Red-Lucy-Engineering/eater-deluxe/eater-deluxe.step

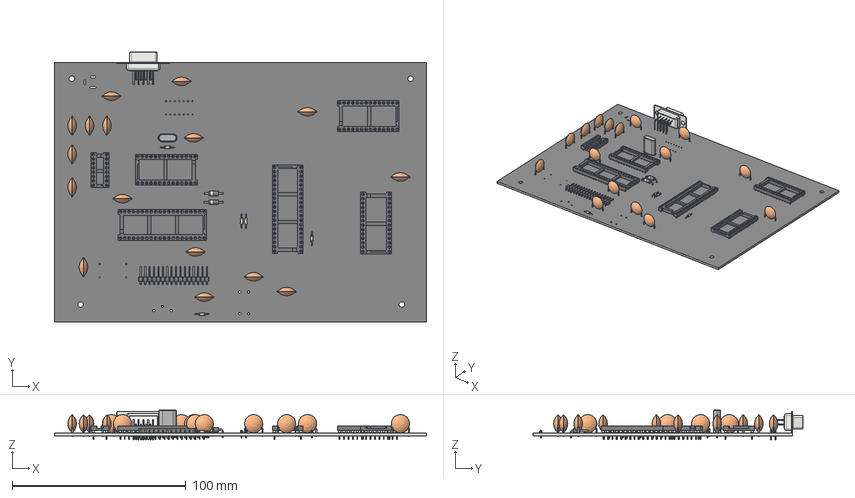
[picture p1: CAD file, 2026-08-22]
eater-deluxe.step
214.2 x 155.4 x 17.0 mm
C_Disc_D105mm_W50mm_P1000mm x 16
DIP_28_W1524mm_Socket x 3
DIP_40_W1524mm_Socket x 2
D_DO-41_SOD81_P10.16mm_Horizontal x 2
PinHeader_1x16_P254mm_Horizontal
R_Axial_DIN0204_L36mm_D16mm_P762mm_Horizontal x 5
DIP_16_W762mm_Socket
Crystal_HC49-U_Vertical
DSUB-9_Socket_Horizontal_P2.77x2.54mm_EdgePinOffset9.40mm
eater-deluxe-unsaved-export-r1S9HQ_soldermask x 2
eater-deluxe-unsaved-export-r1S9HQ_PCB
