Red-Lucy-Engineering/eater-deluxe/schematics/eater-deluxe.pdf

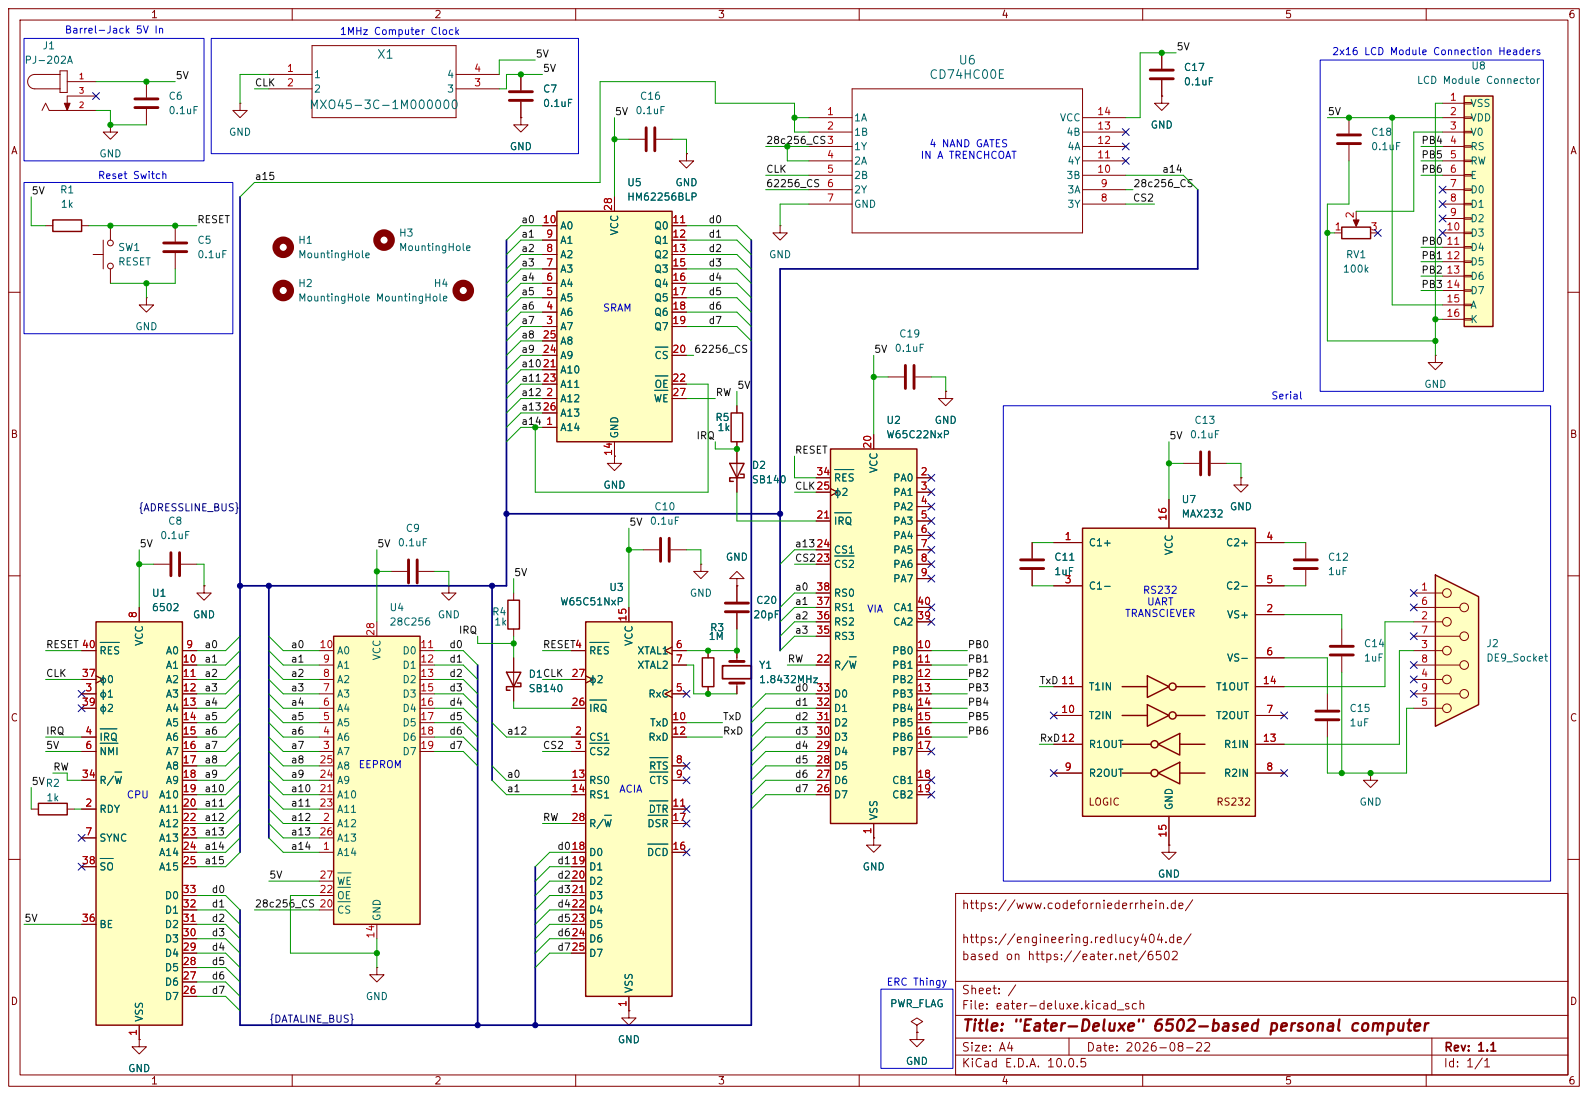
[picture p2: page 1]

https://www.codeforniederrhein.de/ VSS

https://engineering.redlucy404.de/
based on https://eater.net/6502

Sheet: /
File: eater-deluxe.kicad_sch
Title: "Eater-Deluxe" 6502-based personal computer

Size: A4 | Rev: 1.1
KiCad E.D.A. 10.0.5 | Id: 1/1
