Red-Lucy-Engineering/eater-deluxe/eater-deluxe.kicad_pcb

## KiCad design eater-deluxe.kicad_pcb (2026-08-23)

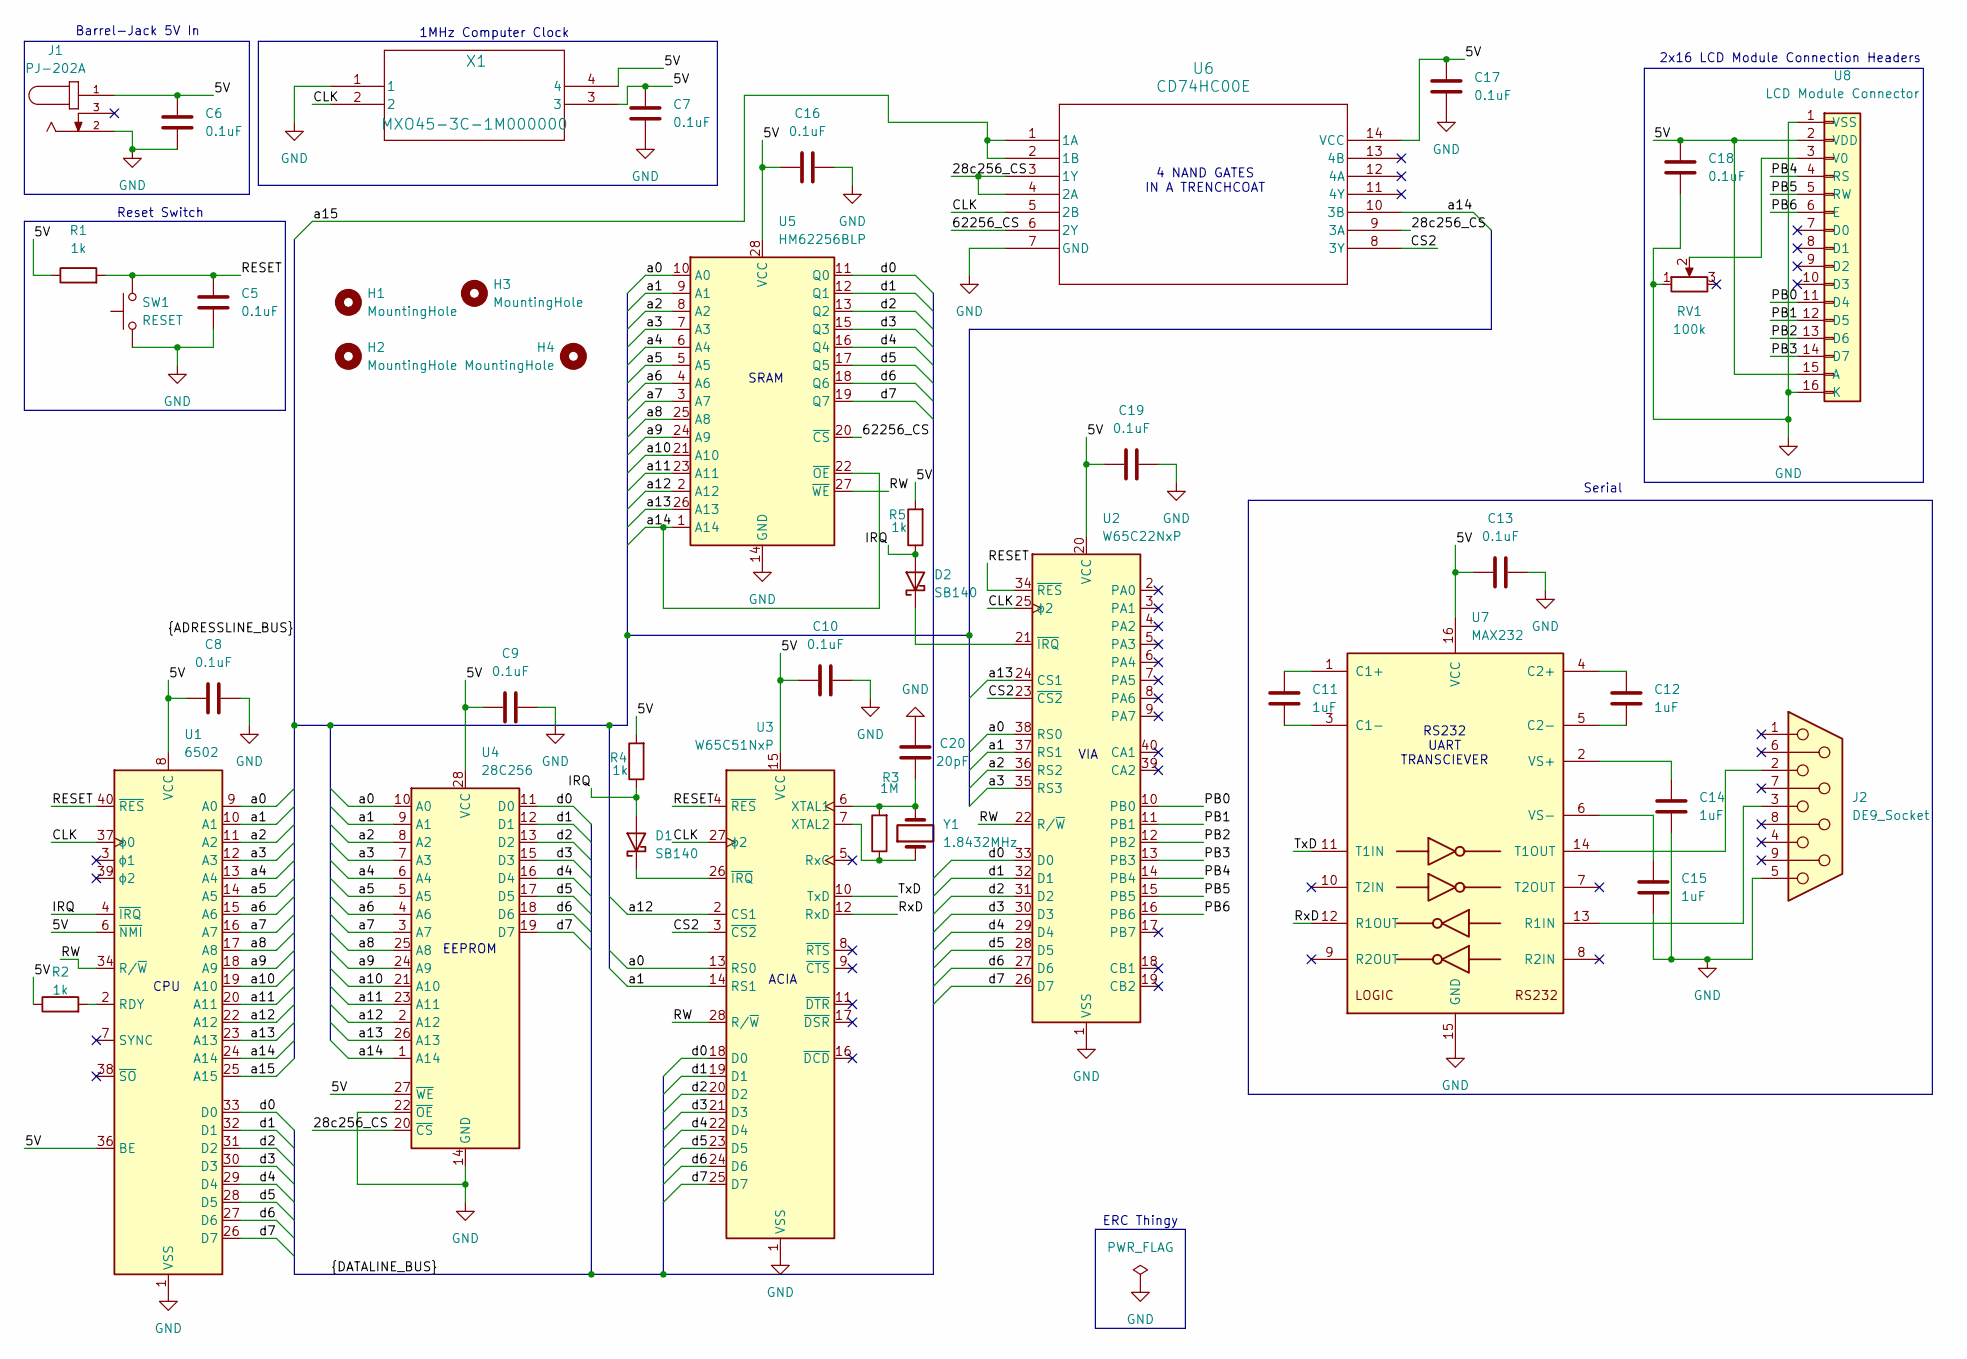
[picture p3: schematic eater-deluxe.kicad_sch, ${TITLE}]

Parts:
C5, C6, C7, C8, C9, C10, C13, C16, C17, C18, C19: 0.1uF; C_Disc_D4.3mm_W1.9mm_P5.00mm
C11, C12, C14, C15: 1uF; C_Disc_D4.3mm_W1.9mm_P5.00mm
C20: 20pF; C_Disc_D4.3mm_W1.9mm_P5.00mm
D1, D2: SB140; D_DO-41_SOD81_P10.16mm_Horizontal
H1, H2, H3, H4: MountingHole; MountingHole_3.2mm_M3_DIN965_Pad
J1: PJ-202A; CUI_PJ-202A
J2: DE9_Socket; DSUB-9_Socket_Horizontal_P2.77x2.54mm_EdgePinOffset9.40mm
R1, R2, R4, R5: 1k; R_Axial_DIN0204_L3.6mm_D1.6mm_P7.62mm_Horizontal
R3: 1M; R_Axial_DIN0204_L3.6mm_D1.6mm_P7.62mm_Horizontal
RV1: 100k; Potentiometer_ACP_CA14-H2,5_Horizontal
SW1: RESET; SW_PUSH-12mm
U1: 6502; DIP-40_W15.24mm_Socket
U2: W65C22NxP; DIP-40_W15.24mm_Socket
U3: W65C51NxP; DIP-28_W15.24mm_Socket
U4: 28C256; DIP-28_W15.24mm_Socket
U5: HM62256BLP; DIP-28_W15.24mm_Socket
U6: CD74HC00E; N14
U7: MAX232; DIP-16_W7.62mm_Socket
U8: LCD Module Connector; PinHeader_1x16_P2.54mm_Horizontal
X1: MXO45-3C-1M000000; DIP4_MXO45-3C-1M000000_CTS
Y1: 1.8432MHz; Crystal_HC49-U_Vertical

Connections:
/5V: C6.2, C7.2, C8.1, C9.1, C10.1, C13.1, C16.1, C17.2, C18.2, C19.1, J1.1, R1.1, R2.1, R4.2, R5.2, U1.6 (~NMI), U1.8 (VCC), U1.36 (BE), U2.20 (VCC), U3.15 (VCC), U4.27 (~WE), U4.28 (VCC), U5.28 (VCC), U6.14 (VCC), U7.16 (VCC), U8.2 (VDD), U8.15 (A), X1.3, X1.4
/28c256_CS: U4.20 (~CS), U6.3 (1Y), U6.4 (2A), U6.9 (3A)
/62256_CS: U5.20 (~CS), U6.6 (2Y)
/CLK: U1.37 (ϕ0), U2.25 (ϕ2), U3.27 (ϕ2), U6.5 (2B), X1.2
/CS2: U2.23 (~CS2), U3.3 (~CS2), U6.8 (3Y)
/IRQ: D1.2 (A), D2.2 (A), R4.1, R5.1, U1.4 (~IRQ)
/PB0: U2.10 (PB0), U8.11 (D4)
/PB1: U2.11 (PB1), U8.12 (D5)
/PB2: U2.12 (PB2), U8.13 (D6)
/PB3: U2.13 (PB3), U8.14 (D7)
/PB4: U2.14 (PB4), U8.4 (RS)
/PB5: U2.15 (PB5), U8.5 (RW)
/PB6: U2.16 (PB6), U8.6 (E)
/RESET: C5.2, R1.2, SW1.2, U1.40 (~RES), U2.34 (~RES), U3.4 (~RES)
/RW: U1.34 (R/~W), U2.22 (R/~W), U3.28 (R/~W), U5.27 (~WE)
/RxD: U3.12 (RxD), U7.12 (R1OUT)
/TxD: U3.10 (TxD), U7.11 (T1IN)
/a0: U1.9 (A0), U2.38 (RS0), U3.13 (RS0), U4.10 (A0), U5.10 (A0)
/a1: U1.10 (A1), U2.37 (RS1), U3.14 (RS1), U4.9 (A1), U5.9 (A1)
/a2: U1.11 (A2), U2.36 (RS2), U4.8 (A2), U5.8 (A2)
/a3: U1.12 (A3), U2.35 (RS3), U4.7 (A3), U5.7 (A3)
/a4: U1.13 (A4), U4.6 (A4), U5.6 (A4)
/a5: U1.14 (A5), U4.5 (A5), U5.5 (A5)
/a6: U1.15 (A6), U4.4 (A6), U5.4 (A6)
/a7: U1.16 (A7), U4.3 (A7), U5.3 (A7)
/a8: U1.17 (A8), U4.25 (A8), U5.25 (A8)
/a9: U1.18 (A9), U4.24 (A9), U5.24 (A9)
/a10: U1.19 (A10), U4.21 (A10), U5.21 (A10)
/a11: U1.20 (A11), U4.23 (A11), U5.23 (A11)
/a12: U1.22 (A12), U3.2 (CS1), U4.2 (A12), U5.2 (A12)
/a13: U1.23 (A13), U2.24 (CS1), U4.26 (A13), U5.26 (A13)
/a14: U1.24 (A14), U4.1 (A14), U5.1 (A14), U5.22 (~OE), U6.10 (3B)
/a15: U1.25 (A15), U6.1 (1A), U6.2 (1B)
/d0: U1.33 (D0), U2.33 (D0), U3.18 (D0), U4.11 (D0), U5.11 (Q0)
/d1: U1.32 (D1), U2.32 (D1), U3.19 (D1), U4.12 (D1), U5.12 (Q1)
/d2: U1.31 (D2), U2.31 (D2), U3.20 (D2), U4.13 (D2), U5.13 (Q2)
/d3: U1.30 (D3), U2.30 (D3), U3.21 (D3), U4.15 (D3), U5.15 (Q3)
/d4: U1.29 (D4), U2.29 (D4), U3.22 (D4), U4.16 (D4), U5.16 (Q4)
/d5: U1.28 (D5), U2.28 (D5), U3.23 (D5), U4.17 (D5), U5.17 (Q5)
/d6: U1.27 (D6), U2.27 (D6), U3.24 (D6), U4.18 (D6), U5.18 (Q6)
/d7: U1.26 (D7), U2.26 (D7), U3.25 (D7), U4.19 (D7), U5.19 (Q7)
GND: C5.1, C6.1, C7.1, C8.2, C9.2, C10.2, C13.2, C14.2, C15.2, C16.2, C17.1, C18.1, C19.2, C20.2, J1.2, J2.5, RV1.1, SW1.1, U1.1 (VSS), U1.21 (VSS), U2.1 (VSS), U3.1 (VSS), U4.14 (GND), U4.22 (~OE), U5.14 (GND), U6.7 (GND), U7.15 (GND), U8.1 (VSS), U8.16 (K), X1.1
unnamed: D1.1 (K), U3.26 (~IRQ)
unnamed: D2.1 (K), U2.21 (~IRQ)
unnamed: R2.2, U1.2 (RDY)
unnamed: C20.1, R3.2, U3.6 (XTAL1), Y1.2
unnamed: R3.1, U3.7 (XTAL2), Y1.1
unnamed: C11.1, U7.1 (C1+)
unnamed: C11.2, U7.3 (C1-)
unnamed: C12.1, U7.4 (C2+)
unnamed: C12.2, U7.5 (C2-)
unnamed: J2.3, U7.13 (R1IN)
unnamed: J2.2, U7.14 (T1OUT)
unnamed: C14.1, U7.2 (VS+)
unnamed: C15.1, U7.6 (VS-)
unnamed: RV1.2, U8.3 (V0)

Notes on the sheet:
Reset Switch
1MHz Computer Clock
EEPROM
2x16 LCD Module Connection Headers
4 NAND GATES IN A TRENCHCOAT
SRAM
Serial
VIA
CPU
ERC Thingy
RS232 UART TRANSCIEVER
ACIA
Barrel-Jack 5V In

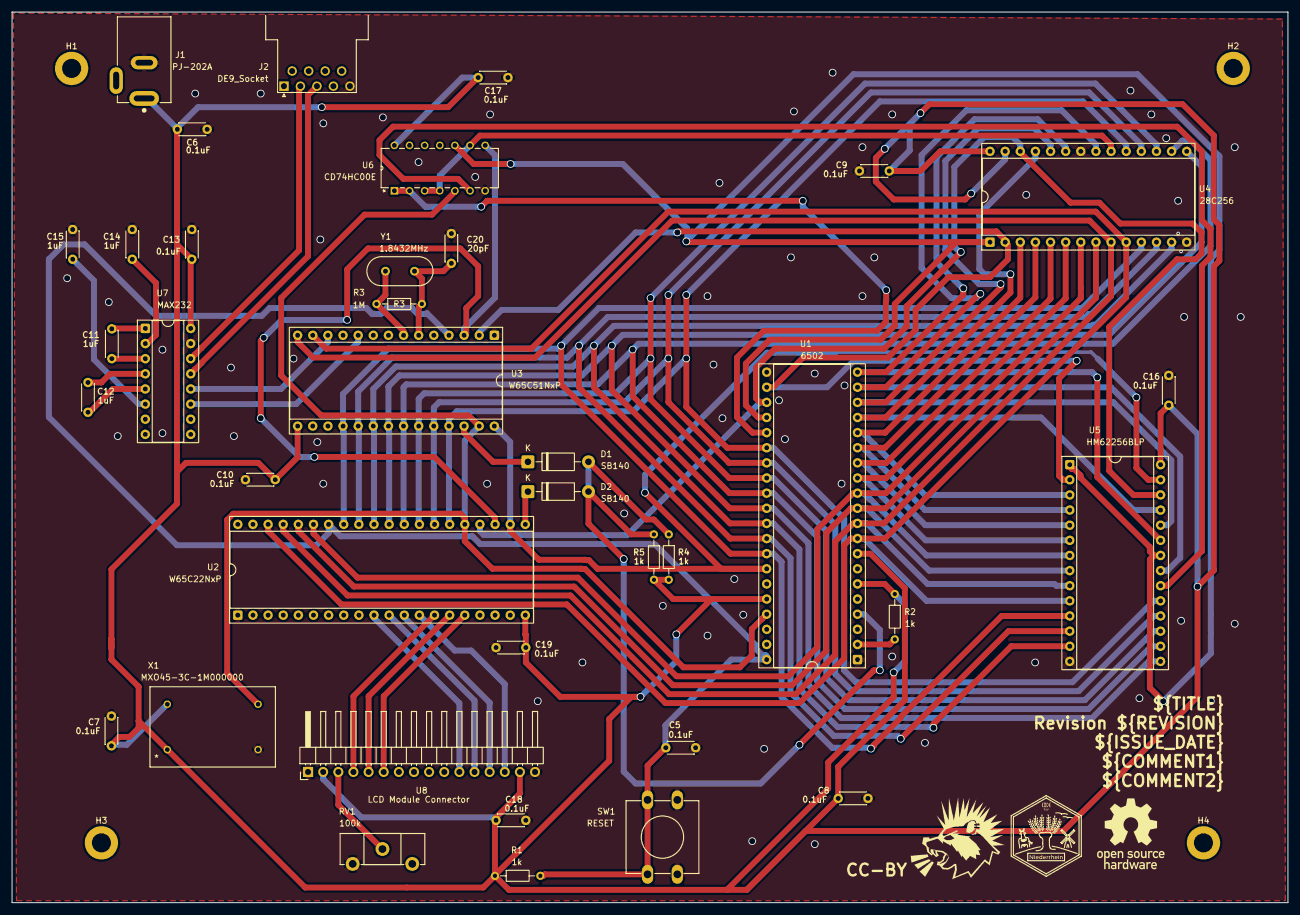
[picture p4: board eater-deluxe.kicad_pcb from above]

Board: 2 copper layers, 214.2 x 149.5 mm, 41 parts (0 on the bottom side), 56 nets.
