Red-Lucy-Engineering/eater-deluxe/(commit log)

2026-08-22 Correct X1 pinout, fix LCD Pins, add pullup resistors for interrupt lines
    [eater-deluxe.kicad_pcb, eater-deluxe.kicad_sch]
2026-08-22 update schematics
    [eater-deluxe.dxf]
2026-08-22 Correct silkscreen labeling
    [eater-deluxe.kicad_pcb, eater-deluxe.step]
2026-08-23 fix Footprint for caps
    were 10mm pitch, now they're 5mm pitch.
    [eater-deluxe-B_Mask.gbs, eater-deluxe-B_Paste.gbp, eater-deluxe-B_Silkscreen.gbo, eater-deluxe-Back.gbl, eater-deluxe-Edge_Cuts.gm1, eater-deluxe-F_Mask.gts, eater-deluxe-F_Paste.gtp, eater-deluxe-F_Silkscreen.gto]
2026-08-31 updated gerbers and BOM list
    [eater-deluxe-B_Mask.gbs, eater-deluxe-B_Paste.gbp, eater-deluxe-B_Silkscreen.gbo, eater-deluxe-Back.gbl, eater-deluxe-Edge_Cuts.gm1, eater-deluxe-F_Mask.gts, eater-deluxe-F_Paste.gtp, eater-deluxe-F_Silkscreen.gto]
