Red-Lucy-Engineering/eater-deluxe/(notices)

Notices in the files:
eater-deluxe.kicad_pcb:
CC-BY
